aku-projects/vision-based-obstacle-avoiding-tello-drone/resources/3d design/autonomousdrone3.stl

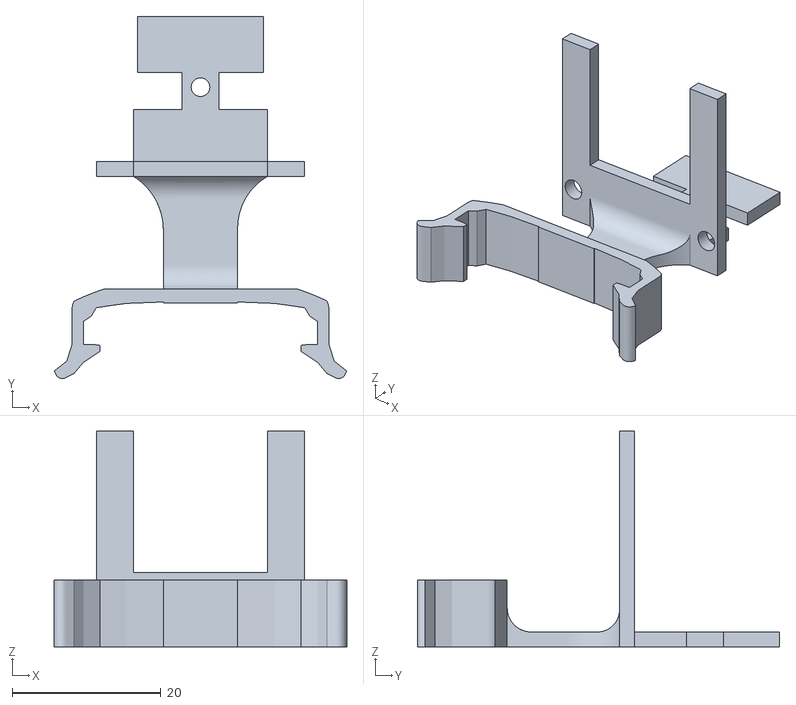
[picture p10: CAD file, 2021-01-10]
resources/3d design/autonomousdrone3.stl
39.3 x 48.7 x 29.0
