aku-projects/vision-based-obstacle-avoiding-tello-drone/resources/3d design/washer.stl

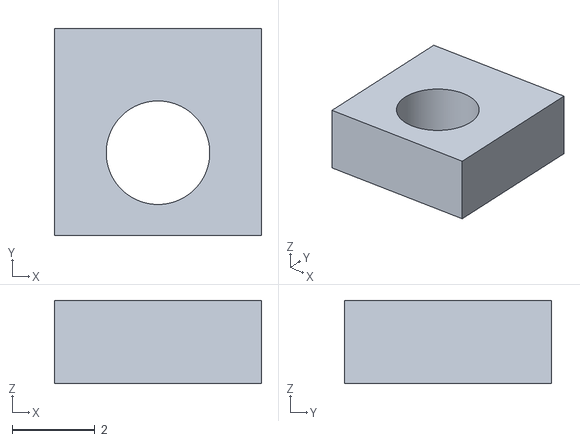
[picture p11: CAD file, 2021-01-10]
resources/3d design/washer.stl
5.00 x 5.00 x 2.01
